SnyUmd/BPS_CAP/最終/基板データ/部品配置図/ArduinoCtrl基板_部品配置図.pdf

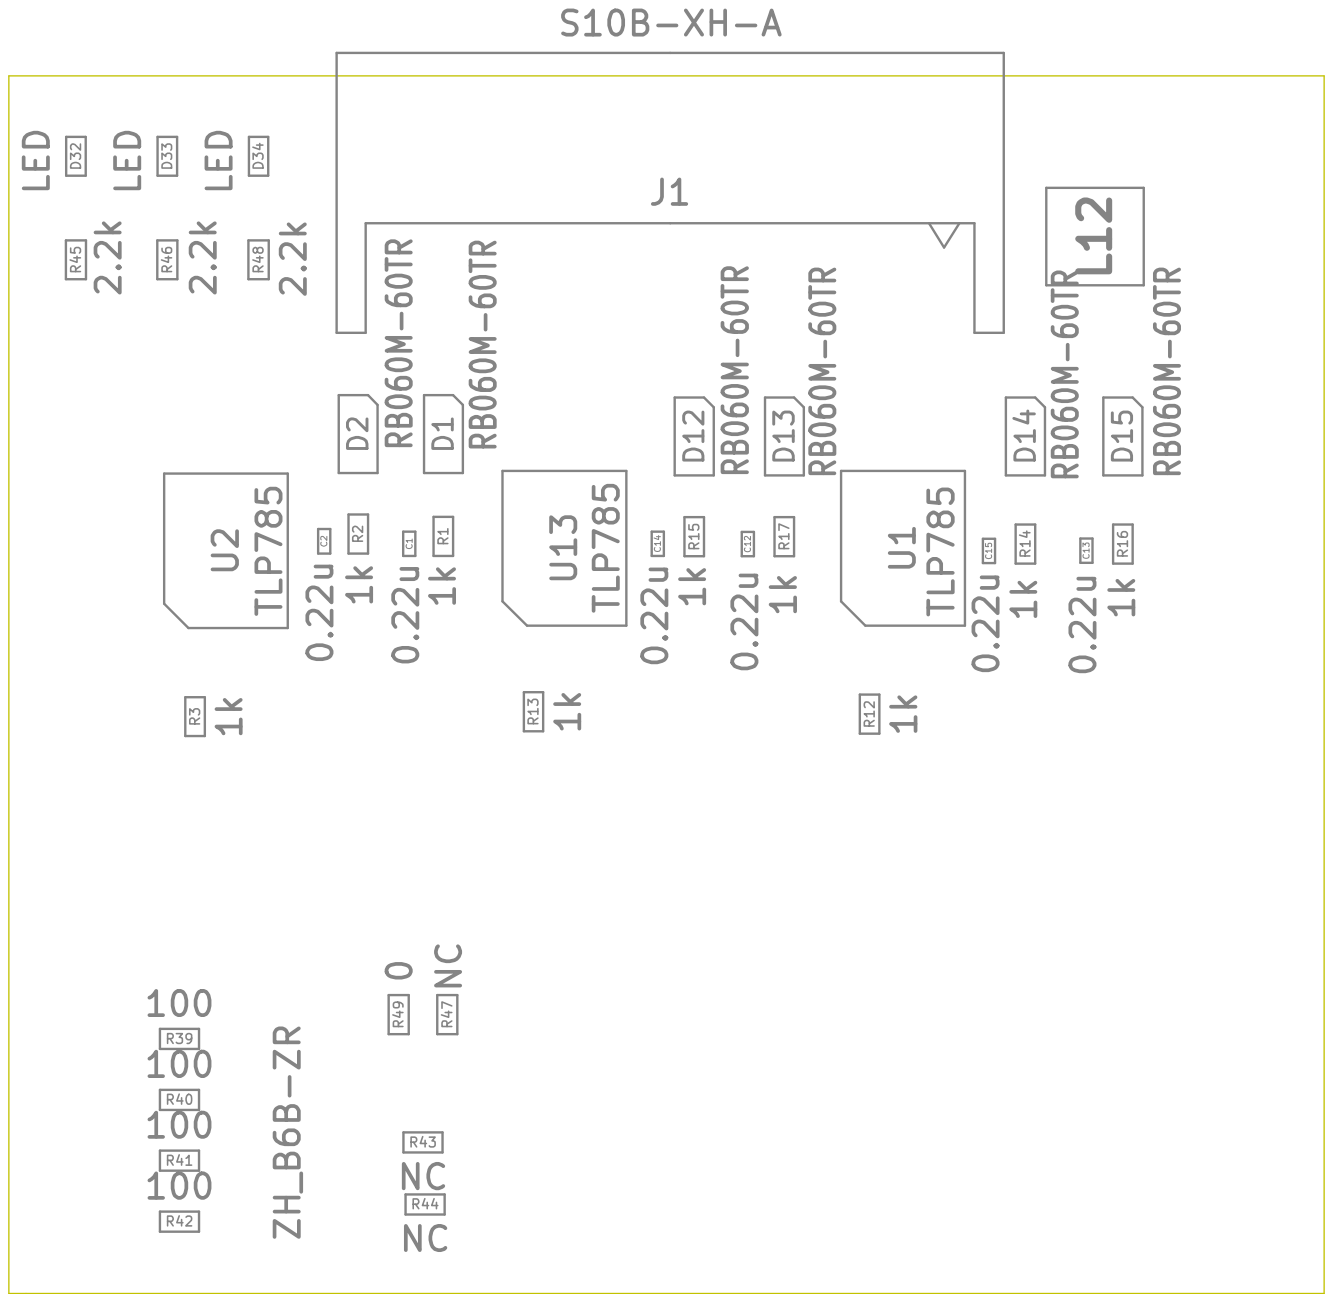
[picture p48: page 1]
