SnyUmd/BPS_CAP/最終/基板データ/部品配置図/PLCポート保護基板_部品配置図.pdf

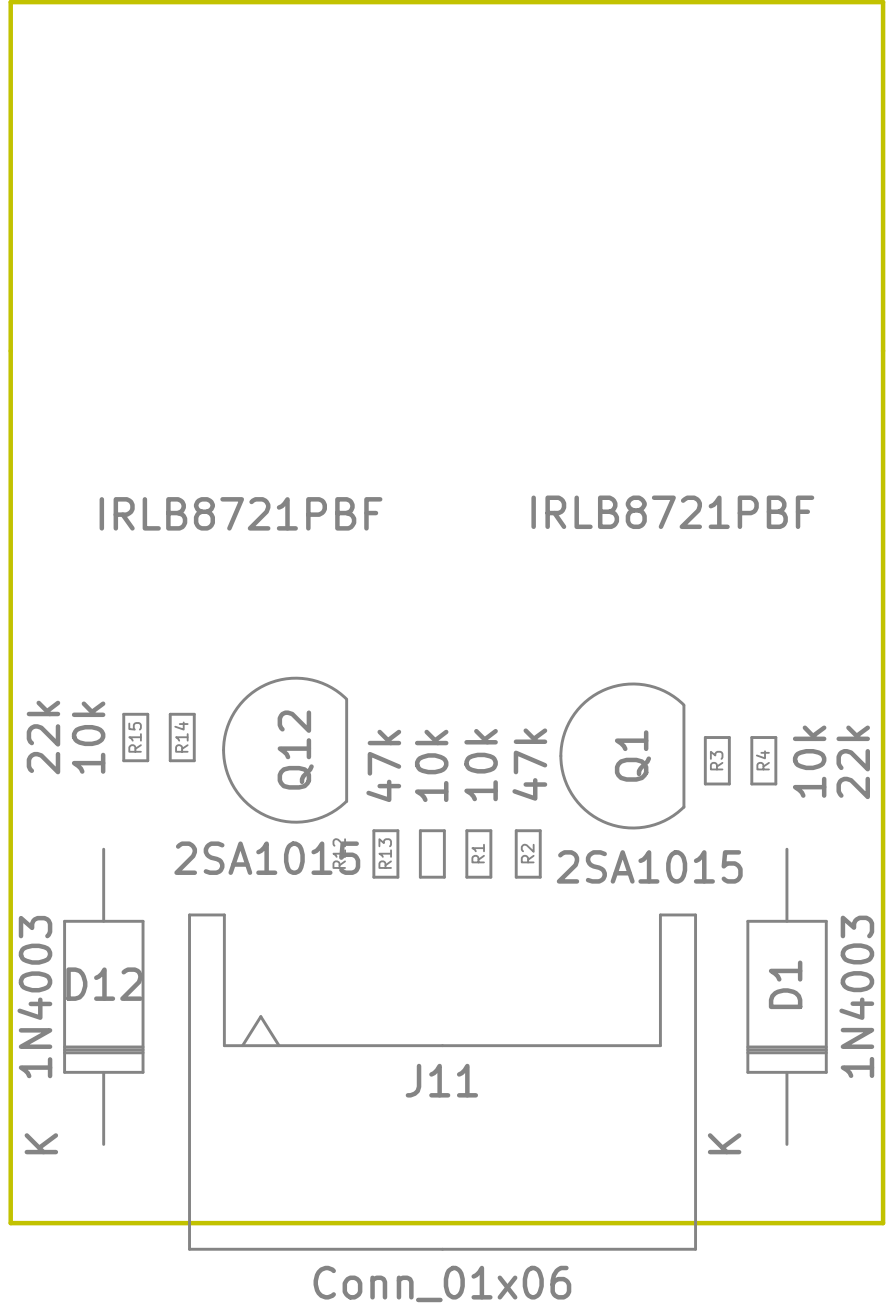
[picture p49: page 1]
