SnyUmd/BPS_CAP/最終/基板データ/回路図/ArduinoCtrl基板_回路図.pdf

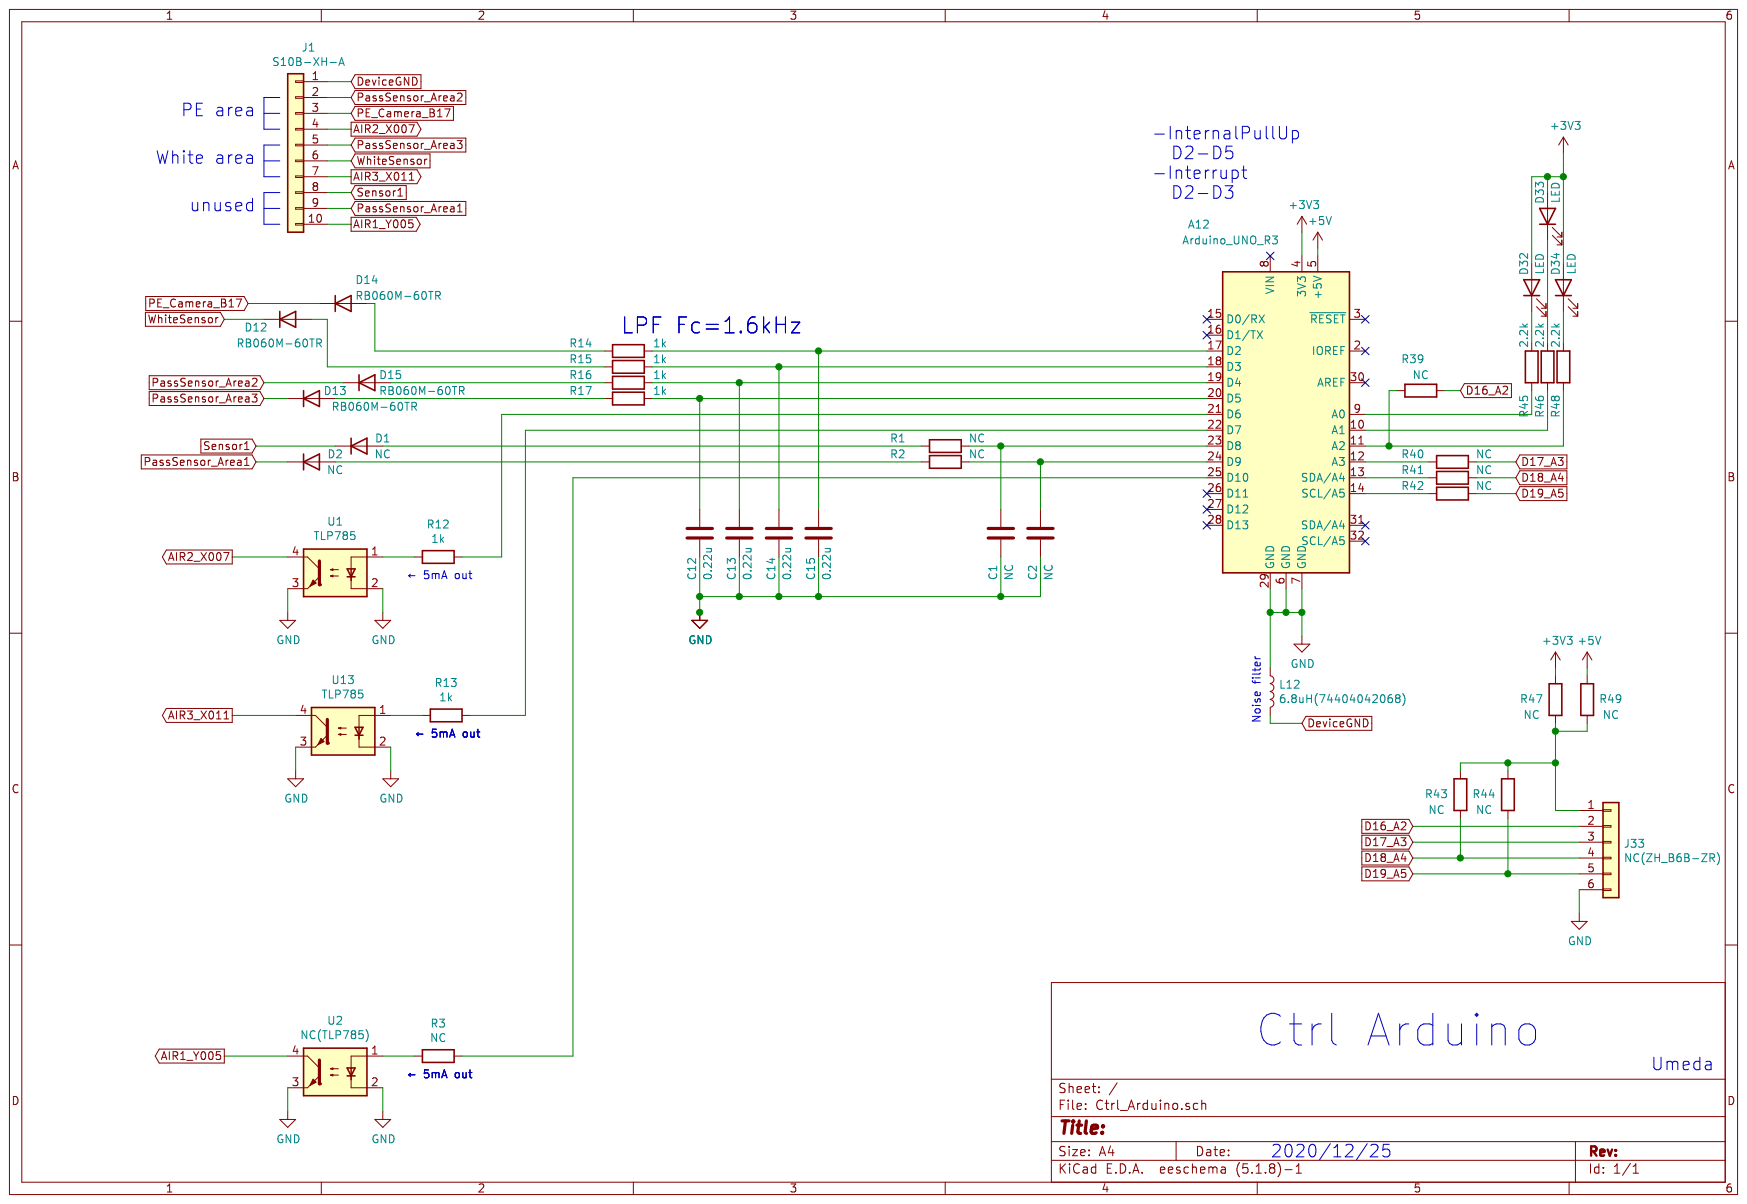
[picture p50: page 1]
