SnyUmd/BPS_CAP/最終/基板データ/回路図/PLCポート保護基板_回路図.pdf

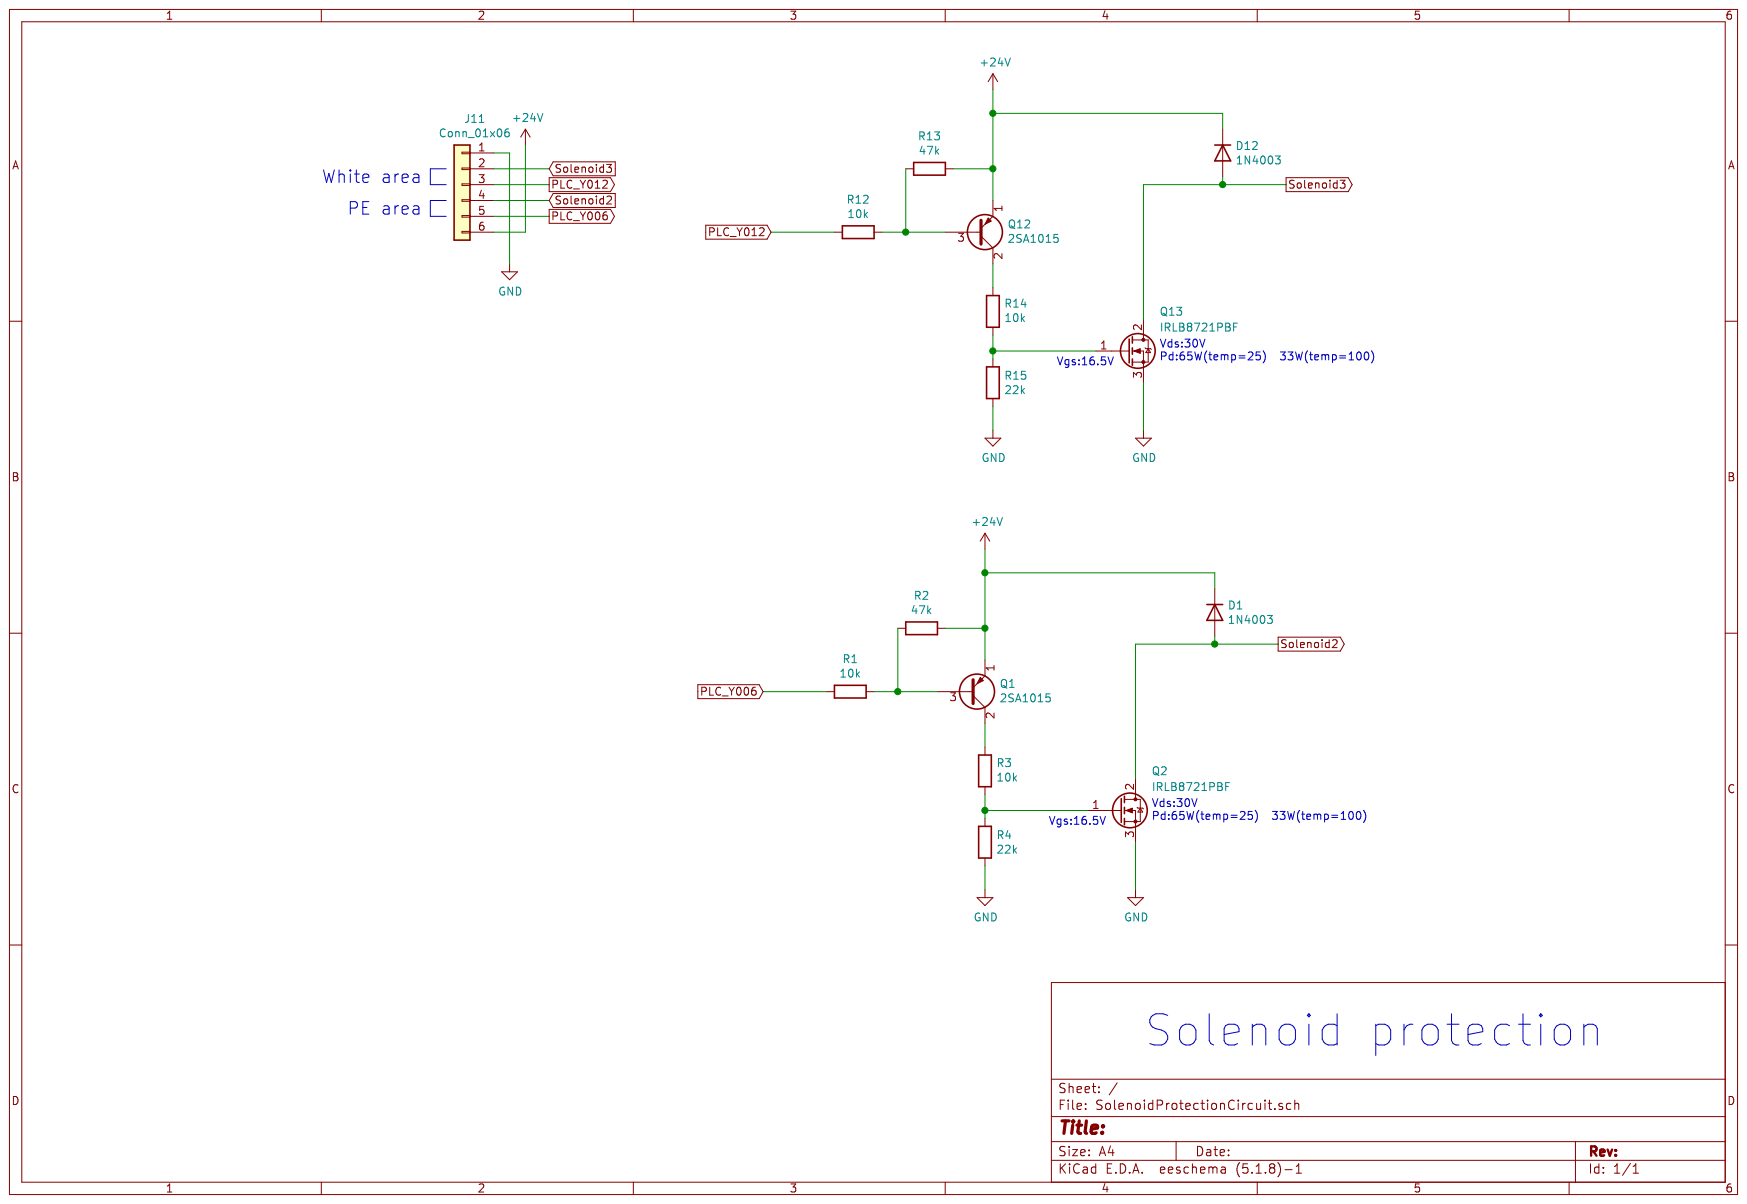
[picture p51: page 1]
