SnyUmd/BPS_CAP/最終/基板データ/KiCAD/CapSorting/Ctrl_Arduino.kicad_pcb

## KiCad design 最終/基板データ/KiCAD/CapSorting/Ctrl_Arduino.kicad_pcb (2022-09-24)

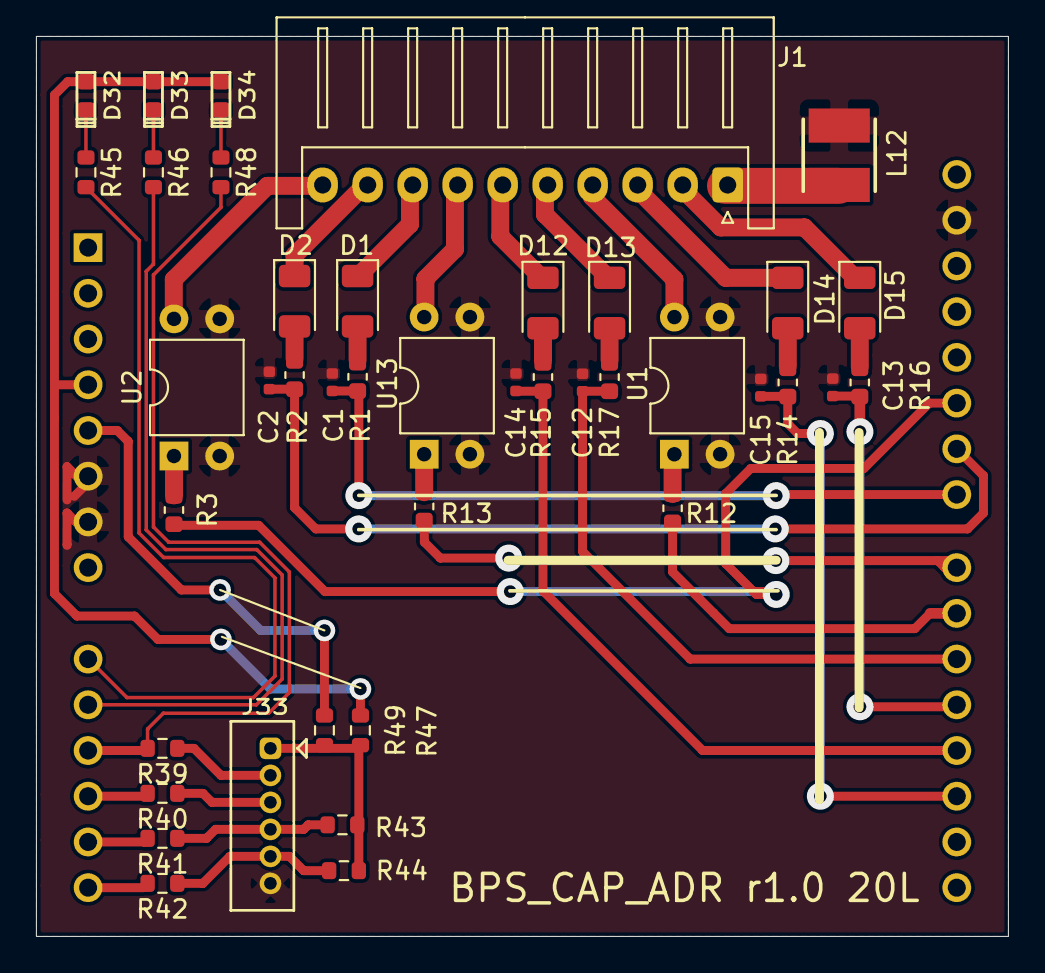
[picture p52: board Ctrl_Arduino.kicad_pcb from above]

Board: 2 copper layers, 54.0 x 50.0 mm, 42 parts (1 on the bottom side), 45 nets.

Parts:
A12: Arduino_UNO_R3; Arduino_UNO_R2
C1, C2, C12, C13, C14, C15: 0.22u; R_0402_1005Metric
D1, D2, D12, D13, D14, D15: RB060M-60TR; D_1206_3216Metric
D32, D33, D34: LED; LED1608
J1: S10B-XH-A; JST_XH_S10B-XH-A_1x10_P2.50mm_Horizontal
J33: ZH_B6B-ZR
L12: 6.8uH(74404042068); INDPM4040X180N
R1, R2, R3, R12, R13, R14, R15, R16, R17: 1k; R_0603_1608Metric
R39, R40, R41, R42: 100; R_0603_1608Metric
R43, R44, R47: NC; R_0603_1608Metric
R45, R46, R48: 2.2k; R_0603_1608Metric
R49: 0; R_0603_1608Metric
U1, U2, U13: TLP785; DIP-4_W7.62mm

Connections:
+3V3: A12.4, D32.2, D33.2, D34.2, R47.2
+5V: A12.5, R49.2
AIR1_Y005: J1.10, U2.4
AIR2_Y006: J1.4, U1.4
AIR3_Y012: J1.7, U13.4
D16_A2: J33.2, R39.1
D17_A3: J33.3, R40.1
D18_A4: J33.4, R41.1, R43.1
D19_A5: J33.5, R42.1, R44.1
DeviceGND: J1.1, L12.2
GND: A12.6, A12.7, A12.29, C1.2, C2.2, C12.2, C13.2, C14.2, C15.2, J33.6, L12.1, U1.2, U1.3, U2.2, U2.3, U13.2, U13.3
unnamed: A12.9, R45.2
unnamed: A12.10, R46.2
unnamed: A12.11, R39.2, R48.2
unnamed: A12.12, R40.2
unnamed: A12.13, R41.2
unnamed: A12.14, R42.2
unnamed: A12.17, C15.1, R14.1
unnamed: A12.18, C14.1, R15.1
unnamed: A12.19, C13.1, R16.1
unnamed: A12.20, C12.1, R17.1
unnamed: A12.21, R12.1
unnamed: A12.22, R13.1
unnamed: A12.23, C1.1, R1.1
unnamed: A12.24, C2.1, R2.1
unnamed: A12.25, R3.1
unnamed: D1.2, R1.2
unnamed: D2.2, R2.2
unnamed: D12.2, R15.2
unnamed: D13.2, R17.2
unnamed: D14.2, R14.2
unnamed: D15.2, R16.2
unnamed: D32.1, R45.1
unnamed: D33.1, R46.1
unnamed: D34.1, R48.1
unnamed: J33.1, R43.2, R44.2, R47.1, R49.1
unnamed: R3.2, U2.1
unnamed: R12.2, U1.1
unnamed: R13.2, U13.1
PE_Camera_B17: D14.1, J1.3
PassSensor_Area1: D2.1, J1.9
PassSensor_Area2: D15.1, J1.2
PassSensor_Area3: D13.1, J1.5
Sensor1: D1.1, J1.8
WhiteSensor: D12.1, J1.6
