SnyUmd/BPS_CAP/最終/基板データ/KiCAD/CapSorting/SolenoidProtectionCircuit.kicad_pcb

## KiCad design 最終/基板データ/KiCAD/CapSorting/SolenoidProtectionCircuit.kicad_pcb (2022-09-24)

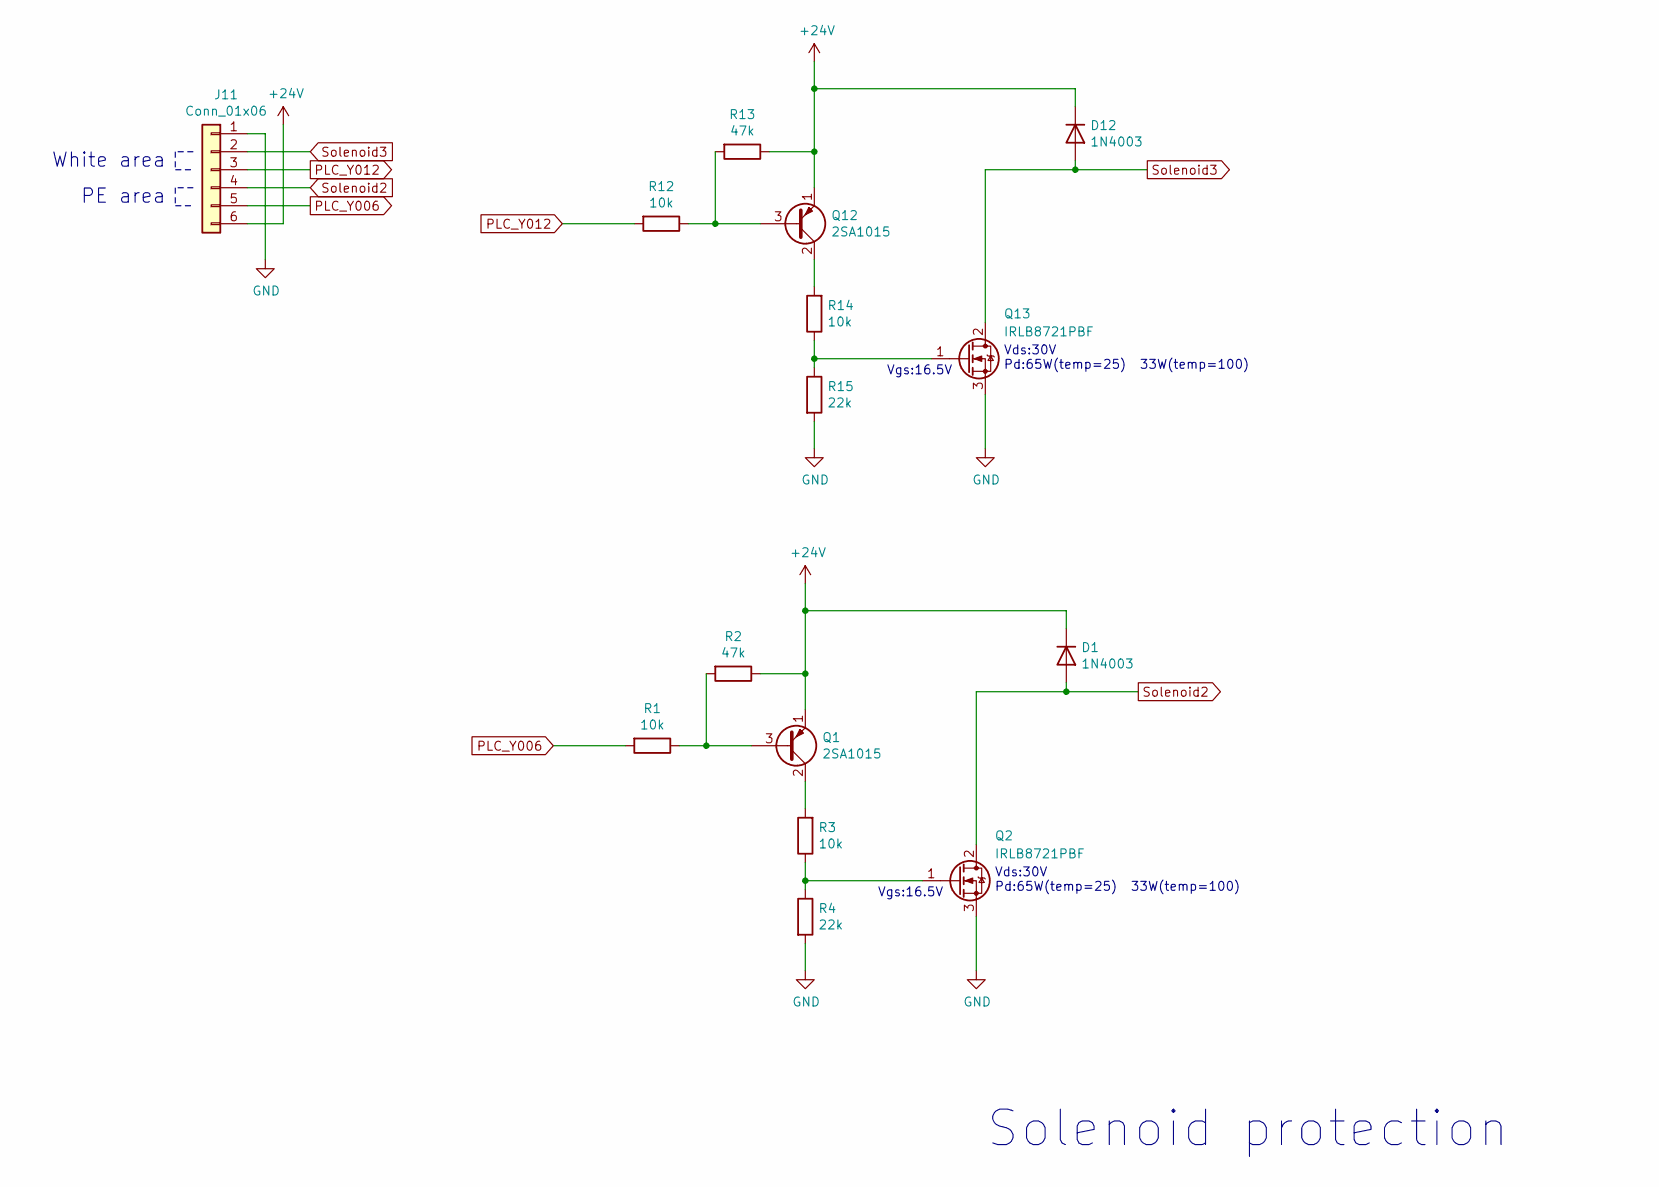
[picture p53: schematic SolenoidProtectionCircuit.sch]

Parts:
D1, D12: 1N4003; D_DO-41_SOD81_P10.16mm_Horizontal
J11: Conn_01x06; JST_XH_S6B-XH-A_1x06_P2.50mm_Horizontal
Q1, Q12: 2SA1015; TO-92_Inline
Q2, Q13: IRLB8721PBF; IRLB8721PBF-2
R1, R3, R12, R14: 10k; R_0603_1608Metric
R2, R13: 47k; R_0603_1608Metric
R4, R15: 22k; R_0603_1608Metric

Connections:
+24V: D1.1 (K), D12.1 (K), J11.6, Q1.1 (E), Q12.1 (E), R2.1, R13.1
GND: J11.1, Q2.3 (S), Q13.3 (S), R4.2, R15.2
unnamed: Q1.2 (C), R3.2
unnamed: Q1.3 (B), R1.1, R2.2
unnamed: Q2.1 (G), R3.1, R4.1
unnamed: Q12.2 (C), R14.2
unnamed: Q12.3 (B), R12.1, R13.2
unnamed: Q13.1 (G), R14.1, R15.1
PLC_Y006: J11.3, R12.2
PLC_Y012: J11.5, R1.2
Solenoid1: D12.2 (A), J11.2, Q13.2 (D)
Solenoid2: D1.2 (A), J11.4, Q2.2 (D)

Notes on the sheet:
Solenoid protection
Vgs:16.5V
Vds:30V Pd:65W(temp=25) 33W(temp=100)
PE area
White area

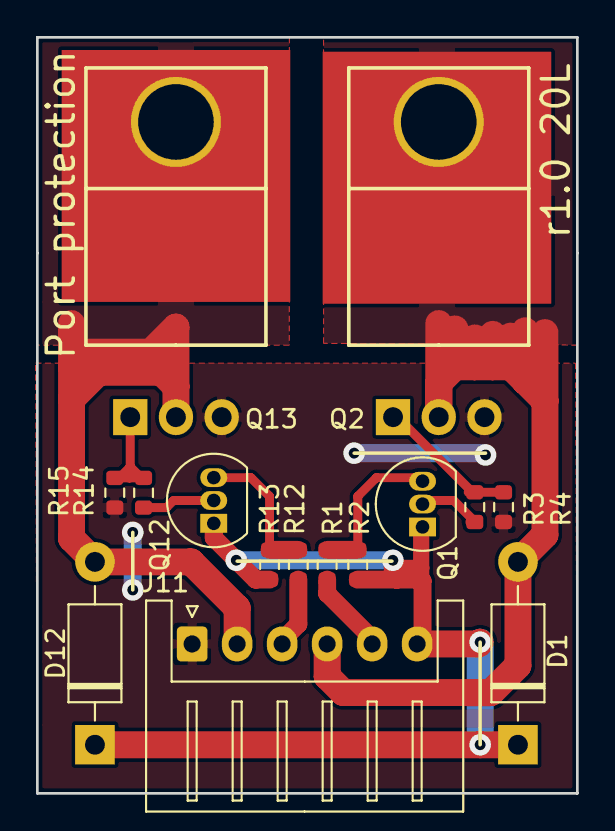
[picture p54: board SolenoidProtectionCircuit.kicad_pcb from above]

Board: 2 copper layers, 30.0 x 42.0 mm, 15 parts (0 on the bottom side), 12 nets.
