SnyUmd/BPS_CAP/(commit log)

2020-12-16 Timer参考ページ追加
2020-12-26 LED追加 Init.h追加 Def.h追加 Timer.h中身追加
2020-12-26 コード整理
2022-09-24 最終版を追加
    [CapSorting.sch, Ctrl_Arduino.kicad_pcb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]
